hmbusch/Quadcopter/README.md

Quadcopter
==========

A quadcopter of my own design
