hmbusch/Quadcopter/electronics/nanowii-i2c-mounting-board/nanowii-i2c-mounting-board.png

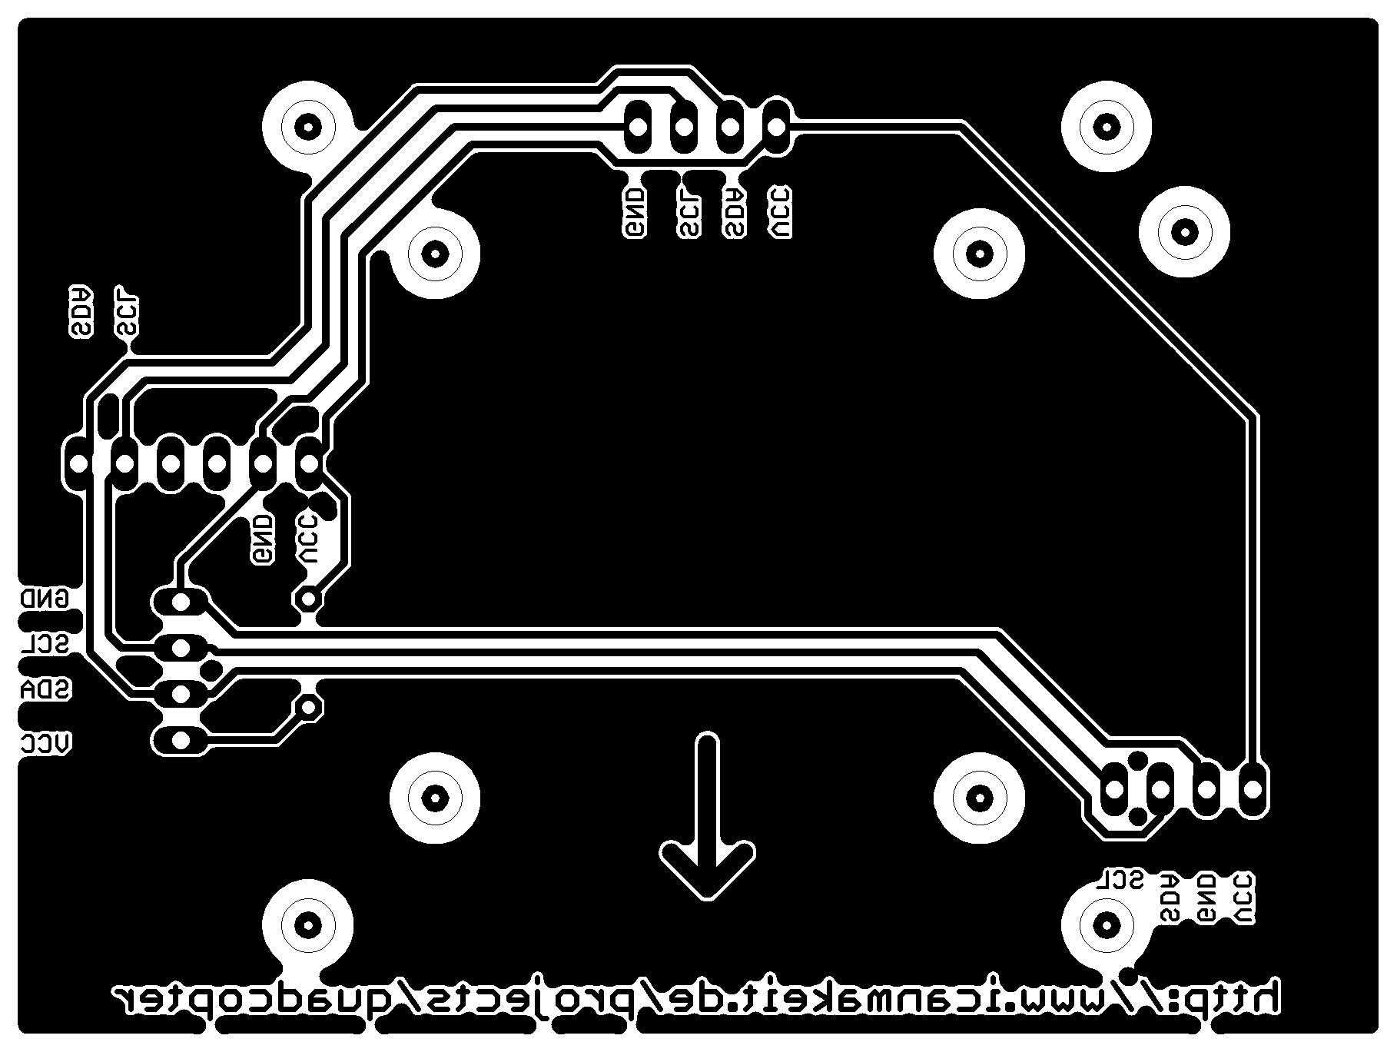
electronics/nanowii-i2c-mounting-board/nanowii-i2c-mounting-board.png
