hmbusch/Quadcopter/electronics/nanowii-i2c-mounting-board/nanowii-i2c-mounting-board.brd

## EAGLE design electronics/nanowii-i2c-mounting-board/nanowii-i2c-mounting-board.brd (2013-06-17)

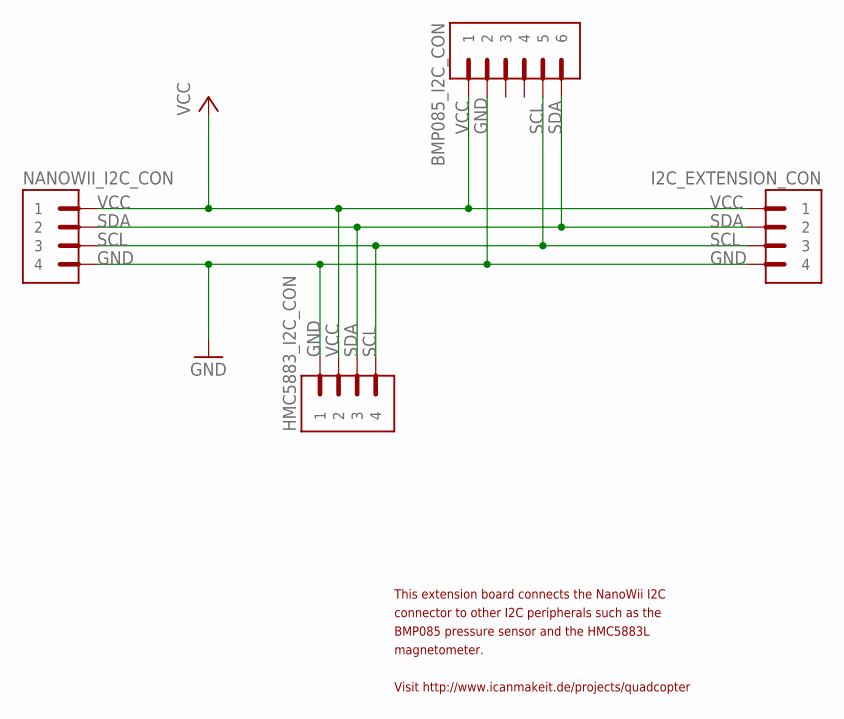
[picture p2: schematic nanowii-i2c-mounting-board.sch]

Parts:
BMP085_I2C_CON: PIN_HEADER_6-WIDE; BREAKAWAY_STRAIGHT_6_WIDE
HMC5883_I2C_CON: PIN_HEADER_4-WIDE; BREAKAWAY_STRAIGHT_4_WIDE
I2C_EXTENSION_CON: PIN_HEADER_4-WIDE; BREAKAWAY_STRAIGHT_4_WIDE
NANOWII_I2C_CON: PIN_HEADER_4-WIDE; BREAKAWAY_STRAIGHT_4_WIDE

Connections:
GND: BMP085_I2C_CON.2, HMC5883_I2C_CON.1, I2C_EXTENSION_CON.4, NANOWII_I2C_CON.4
SCL: BMP085_I2C_CON.5, HMC5883_I2C_CON.4, I2C_EXTENSION_CON.3, NANOWII_I2C_CON.3
SDA: BMP085_I2C_CON.6, HMC5883_I2C_CON.3, I2C_EXTENSION_CON.2, NANOWII_I2C_CON.2
VCC: BMP085_I2C_CON.1, HMC5883_I2C_CON.2, I2C_EXTENSION_CON.1, NANOWII_I2C_CON.1

Notes on the sheet:
This extension board connects the NanoWii I2C
connector to other I2C peripherals such as the
BMP085 pressure sensor and the HMC5883L
magnetometer.
Visit http://www.icanmakeit.de/projects/quadcopter

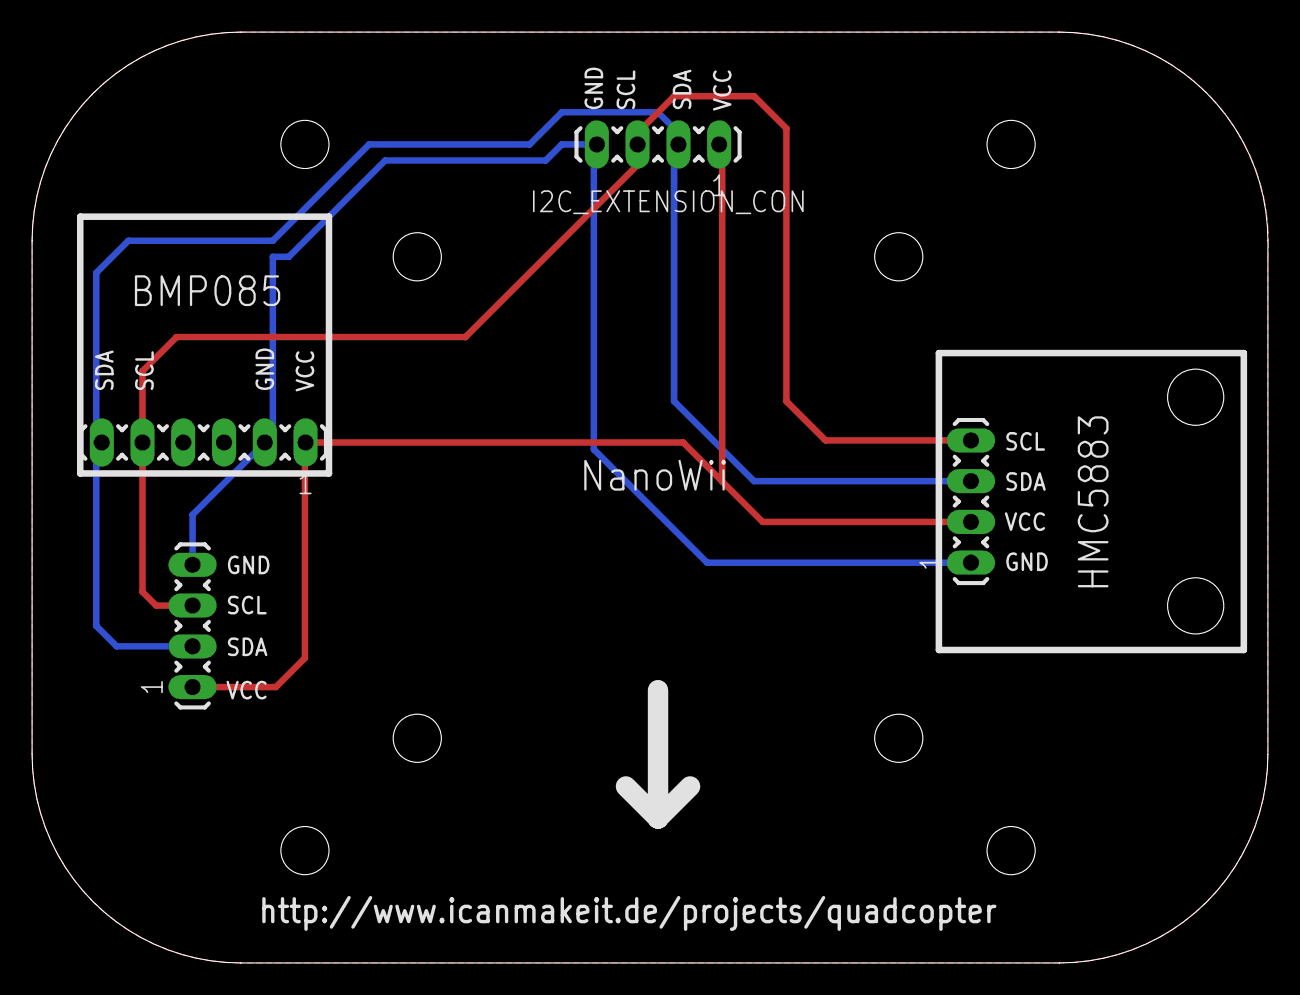
[picture p3: board nanowii-i2c-mounting-board.brd from above]

Board: 2 copper layers, 77.0 x 58.0 mm, 4 parts (0 on the bottom side), 4 nets.
