hmbusch/Quadcopter/(commit log)

2012-06-23 Created a nearly accurate drawing of the mounting plate of a Turnigy Park300 1080kv brushless motor.
2012-06-25 Designed a boom mount for the arms
    Created a boom mounting plate using the previously designed motor
    mounting plate and two tube clamps for 16mm tubes. The design is not
    (yet?) a valid 2D model for laser cutting, only for printing.
2012-06-27 Created the center plates
    Created a top and bottom center plate. Each copter arm will be held by 3
    tube clamps, two on the bottom plate, another on the top plate. In
    future versions, mounting holes for the controller board will be added
    as well as slots for attaching the battery with velcro tape and the ESCs
    with cable binders.
2012-06-28 Created a new version of the center plate
    This version was designed from scratch making extensive use of
    construction help. No guessing and estimating was used during the creation
    process, everything relies on symmetry.
2012-06-28 Created new top & bottom plates using the template
    The newly created template was used to create a new set of center plates.
    For now, only the drill holes for mounting the boom clamps were created,
    assuming 14.2x23mm clamps for 16mm tubes. The drill holes are 4.1mm in
    diameter and suitable for M4 bolts.
    Further holes to mount the PCB and slots to attach the battery and the ESC
    are supposed to follow.
2012-06-29 Converted all drawings to AutoCAD R14 format
    The files were originally created using a demo version of TurboCAD 2D/3D
    Deluxe 19, which turned out to be too expensive to buy so I acquired a
    copy of TurboCAD 2D 16 at a much cheaper price. But Version 16 can't open
    version 19s files and version 19 can only export down to version 17 (which
    in turn again can't be opened by version 16), so I chose to export all
    files to an older AutoCAD format that can be read by version 16 so I would
    be able to continue using my files.
    [01_motor_mounting_plate.dwg, 02_motor_mounting_boom_block.dwg, 03_bottom_center_plate.dwg, 03a_bottom_center_plate_lc.dwg, 04_top_center_plate.dwg, 04a_top_center_plate_lc.dwg, 10_center_plate_template_for_laser_cutter.dwg]
2012-06-30 Created a new center plate template for the diy model from scratch
2012-06-30 Deleted the DWG files as they will be out of date soon
    [01_motor_mounting_plate.dwg, 02_motor_mounting_boom_block.dwg, 03_bottom_center_plate.dwg, 03a_bottom_center_plate_lc.dwg, 04_top_center_plate.dwg, 04a_top_center_plate_lc.dwg, 10_center_plate_template_for_laser_cutter.dwg]
2012-06-30 Created a new version of the bottom center plate using the new template
2012-07-15 Added drill holes for the cable binders holding the ESCs
2012-07-15 Created a new version of the top center plate
    This version was created using the newly created template. Bottom and top
    plate are now precisely chamfered at the edges.
2012-07-18 Fixed a misplaced hole
    One of the hole used to attach the ESC to the plate was misplaced by a few
    millimeters. This has been fixed.
2012-07-19 Added holes for the battery mount
    The battery will be mounted on a separate plate that will be attached to
    the bottom plate via M3 screws with a spacing between the screws large
    enough to accommodate batteries with a width up to 65mm.
    Also added a lot of measurement labels on a separate layer for information
    purposes.
2012-07-21 Created a battery mounting plate
    THe plate measures 9x9cm and is supposed to be attached to the bottom face
    side of the bottom center plate, using some spacers to provide room for
    sliding a piece of velcro tape through it. The plate is deisgned as a
    frame in order so save weight.
2012-07-21 Moved the holes for the battery mount
    In order for the holes on the battery mount to be centered, the holes in
    the bottom plate needed to be moved slightly.
2012-07-21 Enlarged the holes for the battery mount
    The battery mount will now be attached to the bottom center plate using M6
    plastic screws with 50mm length that will also double as a landing support
    for the center part of the copter. Thus the mounting holes on both plated
    were enlarged to 6mm.
2012-07-21 Added mounting holes for the electronics
    Added 3mm mounting holes to hold the power distribution board and the
    flight control module. Also added a meaurements layer.
2012-07-21 Readjusted mounting holes
    The first chosen measure for the electronic mounting holes was a little
    off. This has been corrected.
2012-07-21 Added mounting holes for the X configuration
    With this additional set of holes, the plate can now be used to mount the
    flight control and the receiver in either + or X configuration. The reason
    why the receiver mounting holes differ is that the flight control leaves
    less space on the side between the booms for the receiver.
2012-08-10 Removed receiver mounting holes, added cutting aids
    The receiver is now mounted in a food storage container mounted on top of
    the quadcopter. The mounting holes have therefor been removed.
    Some additional lines to help cutting the plate were added.
2012-08-12 Recreated the motor mounting plate from scratch
    The previous version was not exact enough as it was not designed using
    exact measures and construction lines. This new mounting plate now only
    features the drilling holes and no component outlines.
2012-08-12 Created template for the holes on a boom
2012-08-12 Derived a SVG file from the boom template for printing all 4 booms at once
2012-08-12 Inserted 3 additional copies of the mounting plate for more efficient printing
2012-08-18 Quadrupled the boom drawing for better printing
2012-09-20 Created a PCB to mount the NanoWii and sensors.
    This PCB features the mounting holes required to attach it to the center
    plate and additional ones to hold the NanoWii flight controller and the
    Sparkfun 9DOF stick.
    The PCB provides an I2C bus connection for the NanoWii, the BMP085
    pressure sensor (Sparkfun breakout version) and the 9DOF stick (also
    Sparkfun breakout version). From the 9DOF stick, only the compass will be
    used for the time being, thus it might be more feasible to obtain the
    magnetometer as a single sensor.
    [nanowii-i2c-mounting-board.brd, nanowii-i2c-mounting-board.sch]
2013-03-09 Added etch mask image for the i2c board
    This is intended for single side home etching.
2013-03-09 Replaced the 9DOF stick with single HMC5883 breakout
    Unfortunately, the 9DOF stick interfered with the NanoWii's own sensors on
    the I2C bus. As the HMC5883 magnometer was the only sensor really needed
    from the stick, the design was changed to accomodate a single 5883
    breakout (from Sparkfun) instead of the 9DOF stick.
    The PCB was also changed to double sided and is now intended for
    professional manufacturing.
    [nanowii-i2c-mounting-board.brd, nanowii-i2c-mounting-board.sch]
2013-03-09 Applied DRU for elecfreaks.com manufacturing and created gerber files
    [nanowii-i2c-mounting-board.brd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]
2013-06-17 Started working on a simple 35cm frame
    This frame is intended for my medium sized quadcopter. It is a simple design with an upper and a lower base plate and four rectangular boom. This is my "all-in-one" drawing and it currently only models the lower baseplate. I will split the file onto the individual parts once the design is more mature.
2013-07-03 Created seperate file for the lower base plate
2013-07-05 Added drilling template for the booms
    Also renamed the lower base plate file.
2013-07-14 Added the upper base plate
2013-07-14 Added drill holes for battery mounting plate
2013-07-14 Created a simple plate for mounting the battery.
    With the screws and the landing gear on the bottom side, I needed an even
    surface to attach the battery to. In case of a crash, screws, nuts, etc.
    now won't directly punch into the battery.
2013-07-14 A plate that goes on top of the electronics tower
2014-04-13 Layout for a 40cm wooden H-Quad added
    See http://www.icanmakeit.de/tag/h-quad/ for more details.
2014-04-13 Designed a mounting bracket for the F550
    I purchased a landing gear that could only be fitted to the
    F550 using a custom made mounting bracket out of aluminum.
