hmbusch/Quadcopter/(notices)

Notices in the files:
parts and their libraries:
icmi-connectors: ICMI Custom Parts for EAGLE by Hendrik Busch is licensed under a Creative Commons Attribution-NonCommercial-ShareAlike 3.0 Germany License.
